icl-rocketry/Ricardo-Canardboard/Hardware/Canardboard.kicad_pcb

## KiCad design Hardware/Canardboard.kicad_pcb (2023-07-10)

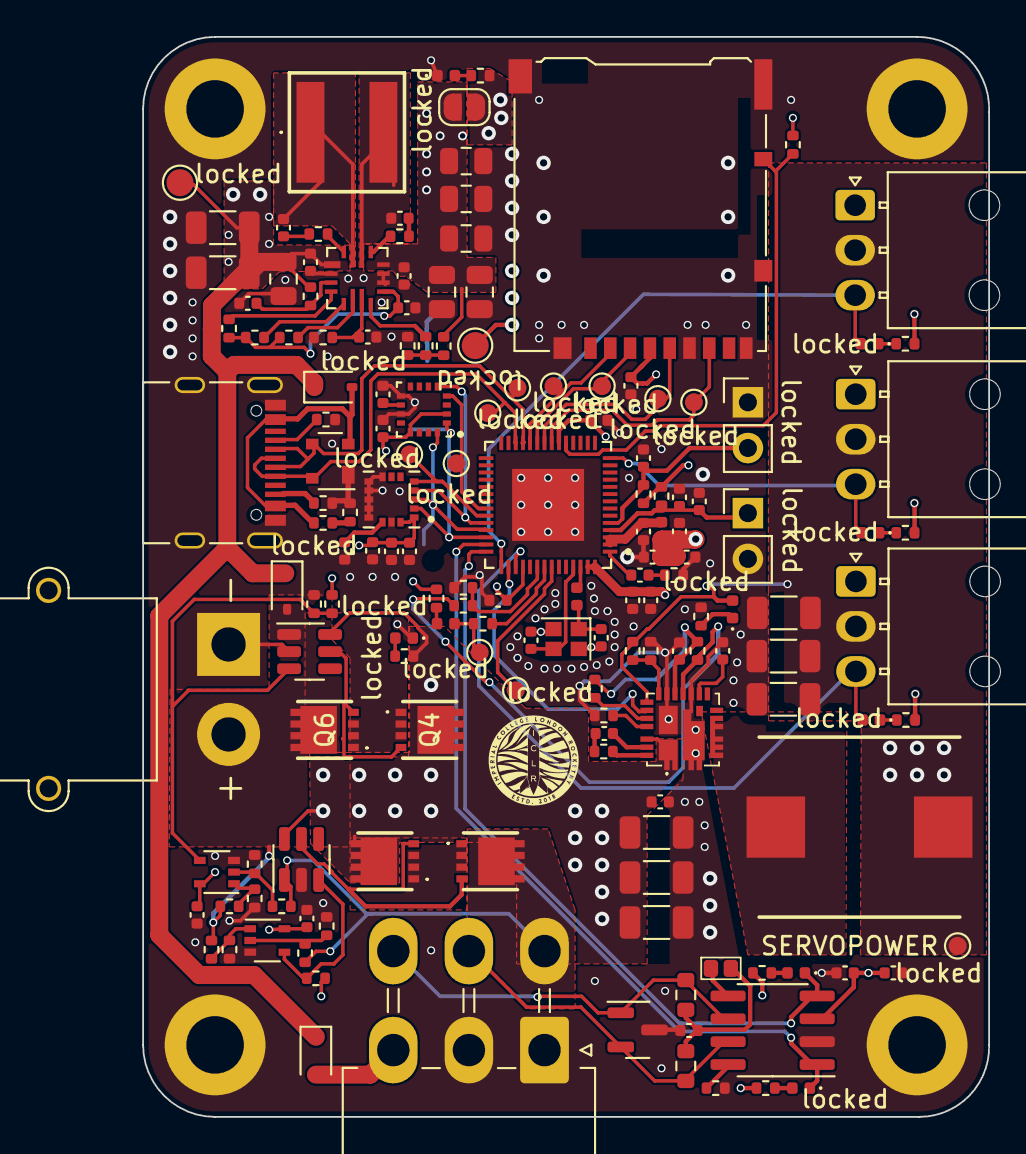
[picture p1: board Canardboard.kicad_pcb from above]

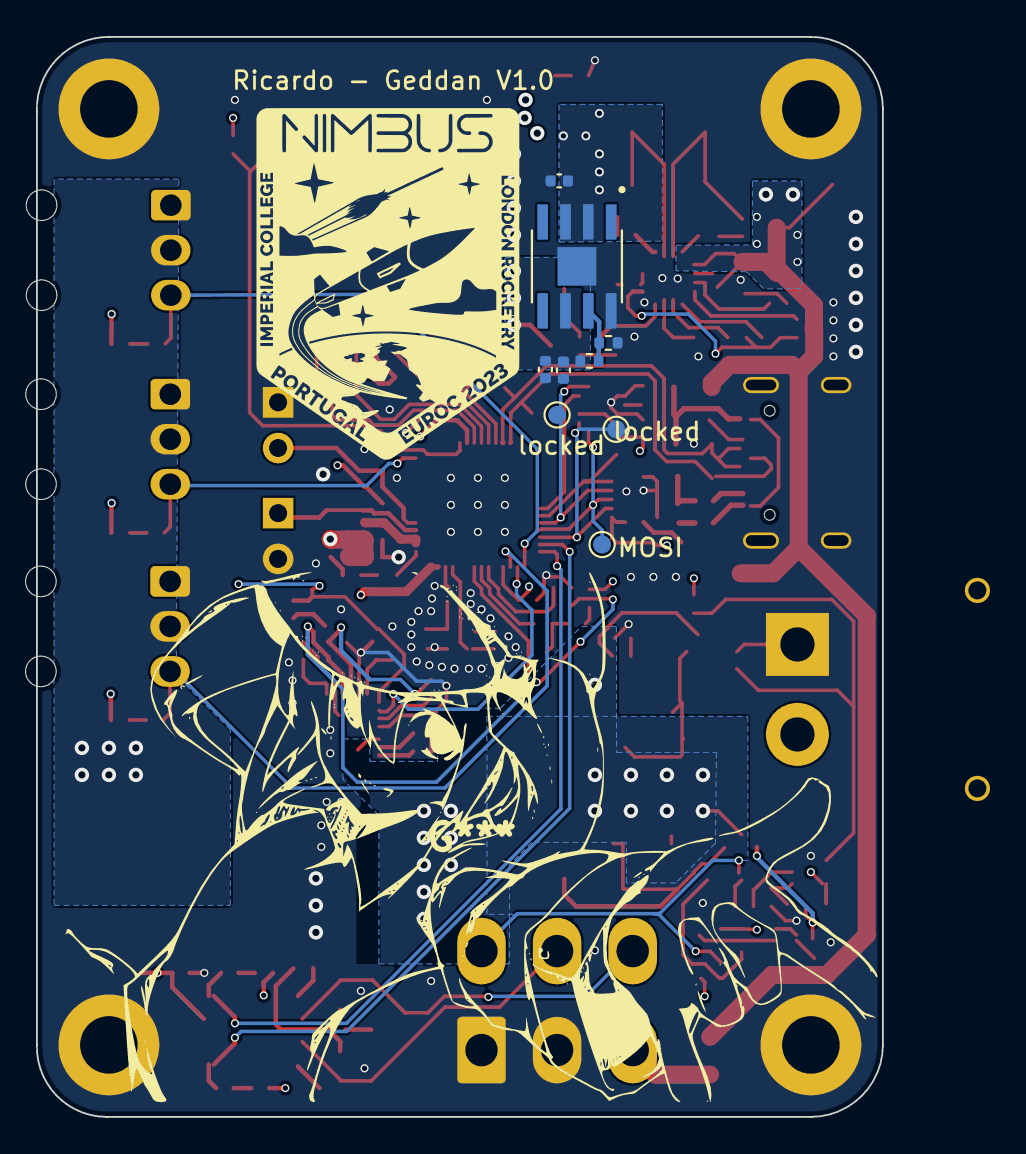
[picture p2: board Canardboard.kicad_pcb from below]

Board: 4 copper layers, 47.0 x 60.0 mm, 171 parts (9 on the bottom side), 94 nets.

Parts:
C1, C16, C29: 10uF; C_0402_1005Metric
C2, C4, C7, C20, C22, C23, C32, C42, C52: 1uF; C_0402_1005Metric
C3, C5, C6, C8, C10, C11, C26, C33, C44: 0.1uF; C_0402_1005Metric
C9, C31: 10nF; C_0402_1005Metric
C12: 4.2pF; C_0402_1005Metric
C13, C14: C; C_0402_1005Metric
C15, C40, C41, C49, C53, C54: 100nF; C_0402_1005Metric
C17: 47nF; C_0402_1005Metric
C18, C19, C35, C36, C37, C39, C45, C46: 47uF; C_1206_3216Metric
C21: 4.7uF; C_0402_1005Metric
C24, C25: DNP; C_0402_1005Metric
C30: 0.47uF; C_0402_1005Metric
C34: 2.2uF; C_0402_1005Metric
C43, C50, C51, C56, C57, C58: 22uF; C_0805_2012Metric
C48, C55: 22nF; C_0402_1005Metric
D1: SM712_SOT23; SOT-23
D2: SP0503BAHT; SOT-143
D3, D4, D5: D_Schottky; D_SOD-323
H1, H2, H3, H4: MountingHole_Pad; MountingHole_3.2mm_M3_DIN965_Pad
IC1: SIC437DED-T1-GE3; SiC437BEDT1GE3
J1: RBUS; Molex_Mini-Fit_Jr_5569-06A2_2x03_P4.20mm_Horizontal
J2: USB_C_Receptacle_USB2.0; USB_C_Receptacle_Palconn_UTC16-G
J3: Micro_SD_Card_Det; microSD_HC_Hirose_DM3AT-SF-PEJM5
J4: Conn_01x02_Male; AMASS_XT30PW-M_1x02_P2.50mm_Horizontal
J5, J6, J7: Conn_01x03_Male; Molex_Nano-Fit_105313-xx03_1x03_P2.50mm_Horizontal
JP1: TermJP; SmallerSolderJP
JP2: TermJP; SolderJumper-2_P1.3mm_Open_RoundedPad1.0x1.5mm
L1: 2.0nH; L_0402_1005Metric
L2: 20nH; L_0402_1005Metric
L4: 2.1uH; INDPM112100X400N
L5: 4.7uH; MPLAL60504R7
MOSI: TestPoint; TestPoint_Pad_D1.0mm
Q1, Q2, Q4, Q6: PXP012-30QLJ; PXP01230QLJ
R1, R3: 10K; R_0402_1005Metric
R2, R4, R13, R15, R42, R44, R46: 470; R_0402_1005Metric
R5: 47.5; R_0402_1005Metric
R6: 499; R_0402_1005Metric
R7, R22: 3k; R_0402_1005Metric
R8, R36, R37, R49: 0; R_0402_1005Metric
R9, R10: 60; R_0603_1608Metric
R11, R12: 5.1k; R_0402_1005Metric
R14, R18, R39, R40, R41: 10k; R_0402_1005Metric
R16, R23, R26, R27, R28, R29, R30, R31, R43, R45: 1k; R_0402_1005Metric
R17: 34k; R_0402_1005Metric
R19, R35, R47, R48: 100k; R_0402_1005Metric
R20: 200k; R_0402_1005Metric
R21: 2.2; R_0402_1005Metric
R24: 1.5k; R_0402_1005Metric
R25: 2.2k; R_0402_1005Metric
R32: 499k; R_0402_1005Metric
R33: 806k; R_0402_1005Metric
R34: 230k; R_0402_1005Metric
R38: 21.5k; R_0402_1005Metric
R50, R51: DNP; R_0402_1005Metric
SERVOPOWER: TestPoint; TestPoint_Pad_D1.0mm
U1: ESP32-S3; QFN40P700X700X90-57N
U2: SN65HVD230; SOIC-8_3.9x4.9mm_P1.27mm
U3, U4: LTC4412xS6; TSOT-23-6
U5: 74AHC1G00; SOT-353_SC-70-5
U6: 74AHC1G08; SOT-353_SC-70-5
U9: SC4215; SOIC127P599X175-9N
U10: MP28167GQ-A-Z
USBLED1: USB_LED; R_0402_1005Metric
Y1: 40MHz±10ppm; Crystal_SMD_2016-4Pin_2.0x1.6mm
locked: SERVOLED; LED_0402_1005Metric
locked#2, locked#6, locked#7, locked#10, locked#11, locked#15, locked#17, locked#18, locked#21, locked#25, locked#26, locked#27: TestPoint; TestPoint_Pad_D1.0mm
locked#3, locked#24: Conn_01x02_Male; PinHeader_1x02_P2.54mm_Vertical
locked#4: TX_LED; LED_0402_1005Metric
locked#5, locked#16: TestPoint; TestPoint_Pad_D1.5mm
locked#8, locked#19: SERVOLED; LED_0402_1005Metric
locked#9: CANRXLED; LED_0402_1005Metric
locked#12: MMC5983MA; PQFN50P300X300X100-16N
locked#13: ICM-20608-G; PQFN50P300X300X80-16N
locked#14: 3V3LED; LED_0402_1005Metric
locked#20: 12V_LED; LED_0402_1005Metric
locked#22: SERVOPWR_LED; LED_0402_1005Metric
locked#23: CANTXLED; LED_0402_1005Metric

Connections:
+3.3V: C1.1, C4.1, C5.1, C7.1, C9.1, C10.1, C11.1, C15.1, C16.1, C20.2, C22.2, C23.2, C25.2, C26.2, C31.1, C32.1, C33.1, C34.1, J3.4 (VDD), JP2.2 (B), L1.1, R1.1, R2.1, R3.1, R4.2, R14.1, R26.1, R27.1, R47.1, R48.1, R50.1, U1.20 (VDD3P3_RTC), U1.46 (VDD3P3_CPU), U1.55 (VDDA), U1.56 (VDDA), U2.3 (VCC), U5.5 (VCC), U6.5 (VCC), U9.6 (VOUT), locked#12.2 (VDD), locked#12.13 (VDDIO), locked#13.1 (VDDIO), locked#13.16 (VDD), locked#16.1
+12V: C39.2, C40.2, C45.2, C46.2, IC1.1 (VIN_1), IC1.2 (VIN_2), IC1.22 (VIN_3), IC1.26 (VIN_4), Q1.5 (D_1), Q1.6 (D_2), Q1.7 (D_3), Q1.8 (D_4), Q1.9 (D_5), Q4.5 (D_1), Q4.6 (D_2), Q4.7 (D_3), Q4.8 (D_4), Q4.9 (D_5), R7.1, U3.6 (SENSE), U4.6 (SENSE)
/BOOT: C8.1, R3.2, U1.5 (GPIO0/BOOT), locked#3.2
/BuckPGOOD: R24.2, R25.1, U1.48 (MTMS/JTAG/GPIO42)
/CAN+: D1.2 (A2), J1.5, R9.1, U2.7 (CANH)
/CAN-: D1.1 (A1), J1.6, R10.2, U2.6 (CANL)
/CAN-BUS/Vref: JP1.1 (A), U2.5 (Vref)
/CAN_RX: U1.42 (GPIO37), U2.4 (R), locked#9.1 (K)
/CAN_TX: U1.41 (GPIO36), U2.1 (D), locked#23.1 (K)
/CHIP_PU: C2.1, C3.1, R1.2, U1.4 (CHIP_PU/RESET), locked#24.1
/Data+: D2.4 (K), J2.A6 (D+), J2.B6 (D+), U1.26 (GPIO20/USB_D+/ADC2_CH9), locked#11.1
/Data-: D2.3 (K), J2.A7 (D-), J2.B7 (D-), U1.25 (GPIO19/USB_D-/ADC2_CH8), locked#25.1
/IMU_CS: U1.37 (SPICLK_P/GPIO47), locked#13.5 (CS), locked#18.1
/MAG_CS: U1.36 (SPICLK_N/GPIO48), locked#10.1, locked#12.4 (~SPI_CS)
/RXD: U1.50 (U0RXD/PROG/GPIO44), locked#7.1
/SD_CLK: J3.5 (CLK), U1.22 (GPIO16/ADC2_CH5/XTAL_32K_N), locked#6.1
/SD_CS: J3.2 (DAT3/CD), U1.24 (GPIO18/ADC2_CH7/DAC_1), locked#2.1
/SD_DET: J3.10 (DET_A), R14.2, U1.19 (GPIO14/ADC2_CH3)
/SD_MISO: J3.7 (DAT0), U1.21 (GPIO15/ADC2_CH4/XTAL_32K_P), locked#17.1
/SD_MOSI: J3.3 (CMD), U1.23 (GPIO17/ADC2_CH6/DAC_2), locked#21.1
/SERVOBUCK_EN: IC1.19 (EN), U1.44 (MTCK/JTAG/GPIO39)
/SERVO_PWR: C35.1, C36.1, C37.1, IC1.18 (VOUT), J5.2, J6.2, J7.2, L4.1, R17.2, SERVOPOWER.1, locked#22.2 (A)
/SERVO_SGNL1: J5.3, U1.43 (GPIO38), locked.2 (A)
/SERVO_SGNL2: J6.3, U1.14 (GPIO9/ADC1_CH8), locked#19.2 (A)
/SERVO_SGNL3: J7.3, U1.45 (MTDO/JTAG/GPIO40), locked#8.2 (A)
/SPI_CLK: U1.40 (GPIO35), locked#12.1 (SCL/SPI_SCK), locked#13.2 (SCL/SCLK), locked#26.1
/SPI_MISO: U1.38 (GPIO33), locked#12.5 (SPI_SDO), locked#13.4 (AD0/SDO), locked#27.1
/SPI_MOSI: MOSI.1, U1.39 (GPIO34), locked#12.16 (SDA/SPI_SDI), locked#13.3 (SDA/SDI)
/TXD: R6.1, locked#4.1 (K), locked#15.1
/rbusmosfets/BatteryPower: D3.2 (A), J4.2, Q6.5 (D_1), Q6.6 (D_2), Q6.7 (D_3), Q6.8 (D_4), Q6.9 (D_5), R16.1, R43.1, U4.1 (VIN)
/rbusmosfets/RBUS_3.3: D4.2 (A), J1.3
/rbusmosfets/RBUS_DEPL: J1.4, Q2.5 (D_1), Q2.6 (D_2), Q2.7 (D_3), Q2.8 (D_4), Q2.9 (D_5), R23.2, R45.2, U3.1 (VIN)
/servopower/PGOOD: IC1.14 (PGOOD), R18.1, R24.1
/servopower/SW: IC1.5 (SW_1), IC1.6 (SW_2), IC1.7 (SW_3), IC1.8 (SW_4), IC1.9 (SW_5), IC1.30 (SW_6), L4.2
/servopower/VDD: C42.1, IC1.15 (VDD), R18.2, R20.2
/servopower/uC_VCC: C52.1, R39.1, R40.1, R41.1, U10.9 (VCC)
/servopower/uC_VOUT: C24.1, C49.1, C50.1, C51.1, C56.1, C57.1, C58.1, JP2.1 (A), R34.1, U9.2 (EN), U9.3 (VIN), U10.12 (OUT)
GND: C1.2, C2.2, C3.2, C4.2, C5.2, C6.2, C7.2, C8.2, C9.2, C10.2, C11.2, C13.2, C14.2, C15.2, C16.2, C17.2, C18.2, C19.2, C20.1, C21.1, C22.1, C23.1, C24.2, C25.1, C26.1, C29.2, C30.2, C31.2, C32.2, C33.2, C34.2, C35.2, C36.2, C37.2, C39.1, C40.1, C41.2, C42.2, C43.2, C45.1, C46.1, C48.1, C49.2, C50.2, C51.2, C52.2, C55.2, C56.2, C57.2, C58.2, D1.3 (common), D2.1 (A), H1.1, H2.1, H3.1, H4.1, IC1.3 (PGND__1), IC1.4 (PGND__2), IC1.13 (PGND__3), IC1.16 (AGND_1), IC1.25 (AGND_2), IC1.27 (PGND__4), IC1.29 (PGND__5), J1.1, J1.2, J2.A1 (GND), J2.A12 (GND), J2.B1 (GND), J2.B12 (GND), J2.S1 (SHIELD), J3.6 (VSS), J3.9 (DET_B), J3.11 (SHIELD), J4.1, J5.1, J6.1, J7.1, R5.1, R8.2, R11.2, R12.1, R15.2, R19.2, R22.2, R25.2, R28.1, R29.1, R30.1, R31.1, R35.2, R38.1, R42.2, R44.2, R46.2, R49.2, R51.2, U1.57 (GND), U2.2 (GND), U3.2 (GND), U4.2 (GND), U5.3 (GND), U6.3 (GND), U9.8 (GND), U9.9 (GND), U10.2 (GND), U10.10 (AGND), U10.11 (GND), USBLED1.1 (K), Y1.2, Y1.4, locked#3.1, locked#12.9 (GND), locked#12.11 (GND), locked#13.8 (FSYNC), locked#13.9 (GND), locked#13.10 (GND), locked#13.11 (GND), locked#13.12 (GND), locked#13.13 (GND), locked#13.15 (GND), locked#14.1 (K), locked#20.1 (K), locked#24.2
unnamed: R4.1, locked#14.2 (A)
unnamed: R7.2, locked#20.2 (A)
unnamed: C6.1, L1.2, U1.2 (VDD3P3), U1.3 (VDD3P3)
unnamed: C12.1, R5.2
unnamed: C14.1, L2.2, Y1.1
unnamed: C44.1, R21.1
unnamed: C53.1, R36.2
unnamed: C54.1, R37.2
unnamed: R27.2, locked#9.2 (A)
unnamed: R26.2, locked#23.2 (A)
unnamed: C44.2, IC1.23 (BOOT)
unnamed: IC1.17 (FB), R17.1, R22.1
unnamed: IC1.21 (MODE1), R19.1
unnamed: IC1.20 (MODE2), R20.1
unnamed: IC1.24 (PHASE), R21.2
unnamed: C21.2, IC1.12 (VDRV)
unnamed: J2.A5 (CC1), R11.1
unnamed: J2.B5 (CC2), R12.2
unnamed: C17.1, JP1.2 (B), R9.2, R10.1
unnamed: Q1.4 (G), Q2.4 (G), U3.5 (GATE)
unnamed: Q1.1 (S_1), Q1.2 (S_2), Q1.3 (S_3), Q2.1 (S_1), Q2.2 (S_2), Q2.3 (S_3)
unnamed: Q4.4 (G), Q6.4 (G), U4.5 (GATE)
unnamed: Q4.1 (S_1), Q4.2 (S_2), Q4.3 (S_3), Q6.1 (S_1), Q6.2 (S_2), Q6.3 (S_3)
unnamed: R15.1, R16.2, U5.1
unnamed: R23.1, R42.1, U5.2
unnamed: R33.1, R34.2, R35.1
unnamed: R43.2, R44.1, U6.1
unnamed: R45.1, R46.1, U6.2
unnamed: R28.2, locked.1 (K)
unnamed: R29.2, locked#19.1 (K)
unnamed: R30.2, locked#8.1 (K)
unnamed: R31.2, locked#22.1 (K)
unnamed: R2.2, locked#4.2 (A)
unnamed: C12.2, U1.1 (LNA_IN/RF)
unnamed: R6.2, U1.49 (U0TXD/PROG/GPIO43)
unnamed: C13.1, U1.53 (XTAL_N), Y1.3
unnamed: L2.1, U1.54 (XTAL_P)
unnamed: R8.1, U2.8 (Rs)
unnamed: R47.2, U3.3 (CTL), U6.4
unnamed: R48.2, R49.1, U4.3 (CTL), U5.4
unnamed: C30.1, locked#13.14 (REGOUT)
unnamed: C29.1, locked#12.10 (CAP)
unnamed: R50.2, R51.1, U9.7 (ADJ)
unnamed: R39.2, U10.4 (ALT)
unnamed: R37.1, U10.16 (BST1)
unnamed: R36.1, U10.13 (BST2)
unnamed: C48.2, R32.2, U10.3 (EN)
unnamed: R33.2, U10.8 (FB)
unnamed: C55.1, R38.2, U10.7 (OC)
unnamed: R40.2, U10.5 (SCL)
unnamed: R41.2, U10.6 (SDA)
unnamed: C54.2, L5.1, U10.15 (SW1)
unnamed: C53.2, L5.2, U10.14 (SW2)
unnamed: R13.2, USBLED1.2 (A)
RBUS_uC_V: C18.1, C19.1, C41.1, C43.1, D3.1 (K), D4.1 (K), D5.1 (K), R32.1, U10.1 (IN), locked#5.1
VBUS: D2.2 (K), D5.2 (A), J2.A4 (VBUS), J2.A9 (VBUS), J2.B4 (VBUS), J2.B9 (VBUS), R13.1
