icl-rocketry/Ricardo-Canardboard/(commit log)

2022-11-08 initial commit
    started repo for canards
    [RicardoTemplate.kicad_sch, can.kicad_sch, usb-uart.kicad_sch]
2022-11-11 tidied up
    [RicardoTemplate.kicad_sch]
2022-11-22 used new esp32 board
    [Canardboard.kicad_pcb, Canardboard.kicad_sch, RicardoTemplate.kicad_sch, can.kicad_sch, components.kicad_sch, power.kicad_sch, usb-uart.kicad_sch]
2023-01-24 pcb roughly organized
    andrei updated his board agaain
    [Canardboard.kicad_pcb, Canardboard.kicad_sch, components.kicad_sch, comps.kicad_sch, power.kicad_sch]
2023-01-24 made everything smaller
    :)
    [Canardboard.kicad_pcb, Canardboard.kicad_sch, comps.kicad_sch, usb-uart.kicad_sch]
2023-01-31 silk screen
    [Canardboard.kicad_pcb]
2023-02-10 changes
    ch
    [Canardboard.kicad_pcb, comps.kicad_sch]
2023-03-31 3rd iteration started
    - mosfet capacitor sized to be super big https://jlcpcb.com/partdetail/Lelon-VEJ222M1ETR1616/C249624
    - Inductor https://www.mouser.co.uk/ProductDetail/Walsin/WLPMA0A040M2R2LC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
    - Buck input capacitors and output capacitors sized, 3x 47uF for both
    Buck:
    - R_FB_H 34kOhms
    - R_FB_L 3kOhms
    [Canardboard.kicad_pcb, Canardboard.kicad_sch, RicardoTemplate.kicad_sch, can.kicad_sch, comps.kicad_sch, power.kicad_sch, servopower.kicad_sch, usb-uart.kicad_sch]
2023-03-31 first draft of PCB layout
    [Canardboard.kicad_pcb]
2023-04-01 error encountered - battery logic and inductor
    - use large capacitor?
    - use VBUS as a power source?
    [Canardboard.kicad_pcb, Canardboard.kicad_sch, power.kicad_sch, servopower.kicad_sch]
2023-04-03 power draft 2, power fixed I think
    10 mosfets now!
    2 each on:
    Servo power: 3s/4s LIPO, RBUS_DEPL
    3.3: VBUS, RBUS_3.3, 3s/4s LIPO
    fixed some capacitors
    [Canardboard.kicad_pcb, Canardboard.kicad_sch, rbusmosfets.kicad_sch, servopower.kicad_sch]
2023-04-04 PCB layout work
    pcb layout work
    [Canardboard.kicad_pcb, Canardboard.kicad_sch, rbusmosfets.kicad_sch, servopower.kicad_sch]
2023-05-20 schematic review updated
    fixed:
    -pin 1 on the bootjumper is missing a connection.
    - Move the SD card to a 2nd SPI bus (so a 2nd set of MISO, MOSI, SCLK) as the rest of the bus is blocked while data is written to it, which would interrupt sensor readings.
    - Add a pull-up resistor on the DET_A pin of the micro SD card, and also connect that pin to the esp32 (picture from pickle)
    - VDD on the IMU (U7) is not connected to any power, should be connected to 3.3V
    - Turns out CAN capacitors C18, C19 actually aren’t needed. It’s up to you if you want to keep them, but if you do keep them could you change their value to “DNP” (stands for Do not place)
    - Add test points to lines which can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
    [Canardboard.kicad_pcb, Canardboard.kicad_sch, can.kicad_sch, comps.kicad_sch, rbusmosfets.kicad_sch, servopower.kicad_sch, usb-uart.kicad_sch]
2023-05-20 I don't want to lose all my changes so I will commit, commit.
    [Canardboard.kicad_pcb, Canardboard.kicad_sch, comps.kicad_sch, rbusmosfets.kicad_sch, servopower.kicad_sch]
2023-05-20 First PCB layout draft
    I need to learn how to properly do fills
    [Canardboard.kicad_pcb, Canardboard.kicad_sch]
2023-05-27 i dont know
    [Canardboard.kicad_pcb, servopower.kicad_sch]
2023-05-27 weird 3v3 and 3.3v bug
    [Canardboard.kicad_pcb, rbusmosfets.kicad_sch, servopower.kicad_sch]
2023-05-28 almost all drc fixed (65 left)
    - J2 hole intersects with pads? USB
    - 3.3 regulator courtyard self intersecting?
    - courtyard overlaps (does this matter?)
    - padstack not valid? this is testpoints on the back with traces on the back, why is this bad?
    - expected SMD actual through hole?
    - front solder mask bridges items ?? testpoitns are on back layer
    [Canardboard.kicad_pcb, rbusmosfets.kicad_sch]
2023-06-01 everything should be fine
    fixed all mask stuff
    [Canardboard.kicad_pcb, comps.kicad_sch]
2023-06-03 fixed all of andrei's comments v1
    [Canardboard.kicad_pcb, Canardboard.kicad_sch, can.kicad_sch, rbusmosfets.kicad_sch]
2023-06-16 roddy changes
    [Canardboard.kicad_pcb, servopower.kicad_sch]
2023-06-16 did some stuffus
    added a new power plane in servo power on the back side
    made SW larger
    and a lot more changes
    [Canardboard.kicad_pcb, Canardboard.kicad_sch, rbusmosfets.kicad_sch]
2023-06-18 latest channges
    dont understand why making more copper is good for thermal
    [Canardboard.kicad_pcb, servopower.kicad_sch]
2023-06-20 all DRC fixed
    andrei hih ih ihi hi hi h
    [Canardboard.kicad_pcb]
2023-06-20 final andrei changes
    lol
    [Canardboard.kicad_pcb, can.kicad_sch]
2023-07-01 silkscreen update
    [Canardboard - Copy.kicad_pcb, Canardboard.kicad_pcb]
2023-07-01 i forgot to save the silkscreen update
    [Canardboard.kicad_pcb]
2023-07-01 more vias
    [Canardboard.kicad_pcb]
2023-07-01 funny wow
    funny wow
    [Canardboard.kicad_pcb]
2023-07-07 new board just dropped
    i hate my life
    [Canardboard - Copy.kicad_pcb, Canardboard.kicad_pcb, Canardboard.kicad_sch, rbusmosfets.kicad_sch]
2023-07-07 some sw stuff
    stuff
    [Canardboard.kicad_pcb]
2023-07-07 lmao funny
    hi
    [Canardboard.kicad_pcb]
2023-07-09 final fixes mybe
    [Canardboard.kicad_pcb, Canardboard.kicad_sch]
2023-07-10 fixed via bypass capacitors
    [Canardboard.kicad_pcb]
2023-07-10 final final changes
    [Canardboard.kicad_pcb]
2023-08-11 ordering changes
    [Canardboard.csv, Canardboard.kicad_pcb, bom.csv, designators.csv, positions.csv]
2023-09-26 i hate you
    i hate you pc for deleting EVERY CHANGES I MADE
    [Canardboard.csv, Canardboard.kicad_pcb, Canardboard.kicad_sch, RicardoTemplate.kicad_sch, bom.csv, can.kicad_sch, comps.kicad_sch, designators.csv]
2024-09-24 nrcgeddan updated for single servo, component updates
2024-10-10 buck behaviour update
